Hatzoru/Domotic-bluetooth/README.md

# ESP32 Security & Domotics System 🛡️🔥

## 📌 Project Overview
A smart home security prototype designed to detect environmental hazards and intrusions. The system uses an ESP32 microcontroller to monitor gas, smoke, motion, and temperature, sending real-time alerts to a mobile device.

## ⚙️ Tech Stack
- **Microcontroller:** ESP32.
- **Sensors:** 
  - MQ-2 (Flammable gas, smoke, and CO detection)
  - PIR SR501 (Motion detection)
- **Communication:** Bluetooth Classic (Bluetooth Terminal app).
- **Actuators:** Buzzer (Alarm), 2x 5V Relays (Exhaust fan and LED lights).

## 🔧 Key Features
- **Gas Alert:** Activates the exhaust fan and buzzer if gas levels exceed the calibrated threshold (using analog ADC reading).
- **Motion Alarm:** Triggers the buzzer if movement is detected while the system is armed.
- **Remote Control:** Used a Bluetooth terminal app to send characters ('a' to 'f') to turn lights on/off, arm alarms, or test sensors.
- **Custom Circuit:** Designed and simulated the entire schematic in Proteus before physical assembly.

## 📸 Media & Documentation
f1
f2
f3
f4
f5
f6
f7
f8

https://github.com/user-attachments/assets/dd6aad47-a3e8-453a-8134-b2874645ebad

https://github.com/user-attachments/assets/d401edcd-4f7a-49cf-82d0-dca85f329f79

https://github.com/user-attachments/assets/303591d0-7f66-4819-aa7c-8c3b71f97572

https://github.com/user-attachments/assets/8e4576c8-b027-40ff-832a-38b9081a313c

## 📝 What I Learned
- Programming microcontrollers using the Arduino IDE (C++).
- Interfacing analog and digital sensors with an ESP32.
- Using optocouplers (PC817) and transistors (BC548) for galvanic isolation and power stages.
- Technical documentation and field notebook tracking.
