Hatzoru/Domotic-bluetooth/Caja 3D.stl

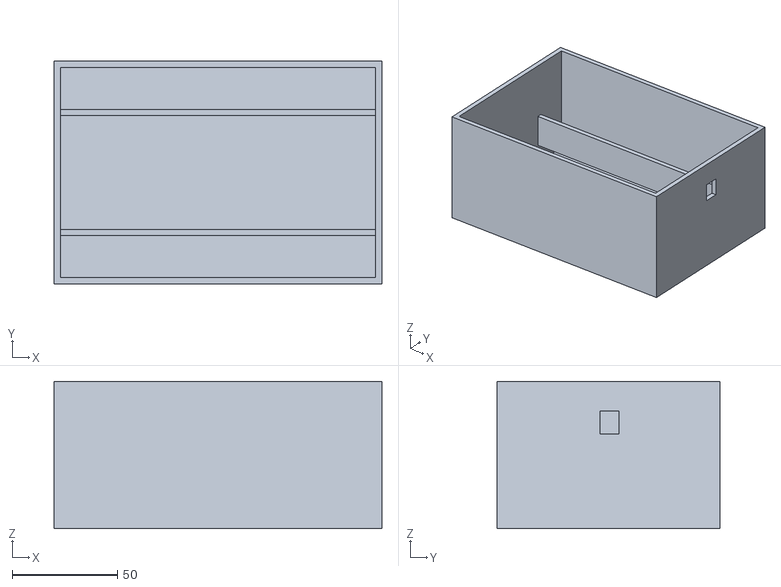
[picture p32: CAD file, 2026-10-24]
Caja 3D.stl
156.0 x 106.0 x 70.0
