Hatzoru/Domotic-bluetooth/Tapa de caja 3D.stl

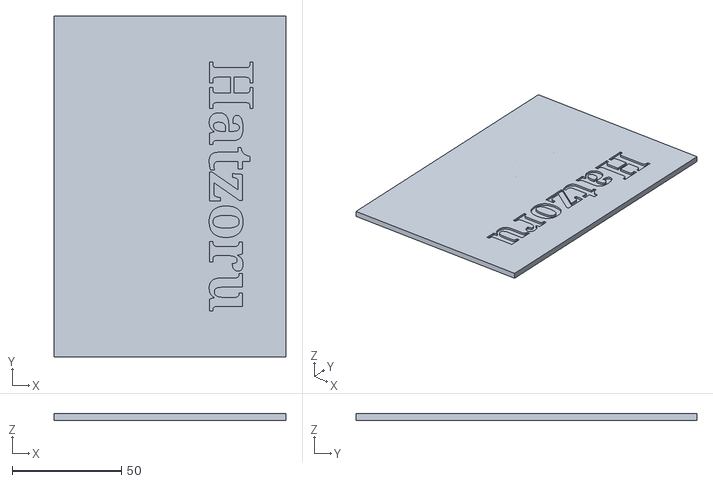
[picture p33: CAD file, 2026-10-24]
Tapa de caja 3D.stl
106.0 x 156.0 x 3.00
