Hatzoru/Domotic-bluetooth/(list of files, drawings)

Other design files:
PROYECTO 3.0 spam 3.pcb
